karlduino/CO2monitorWifi/docs/DrillTemplate/co2_monitor_drill_template.png

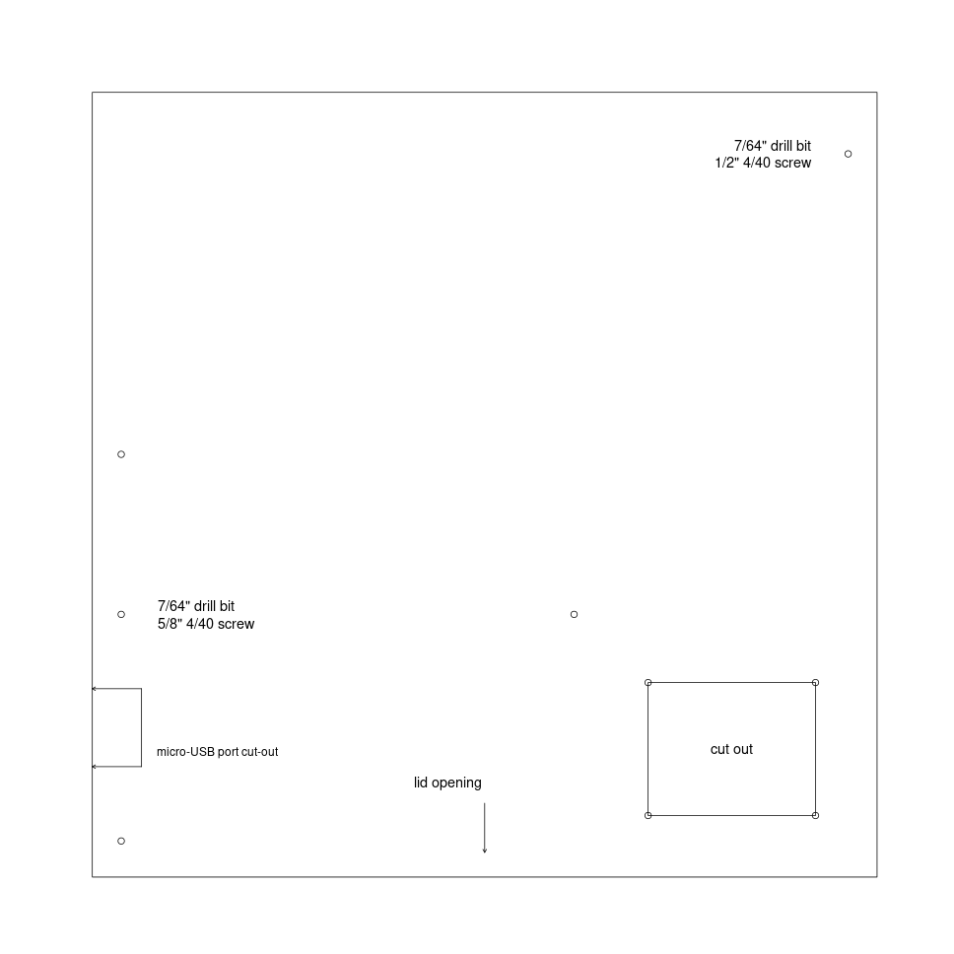
docs/DrillTemplate/co2_monitor_drill_template.png
