karlduino/CO2monitorWifi/docs/pics/01_with_template.jpg

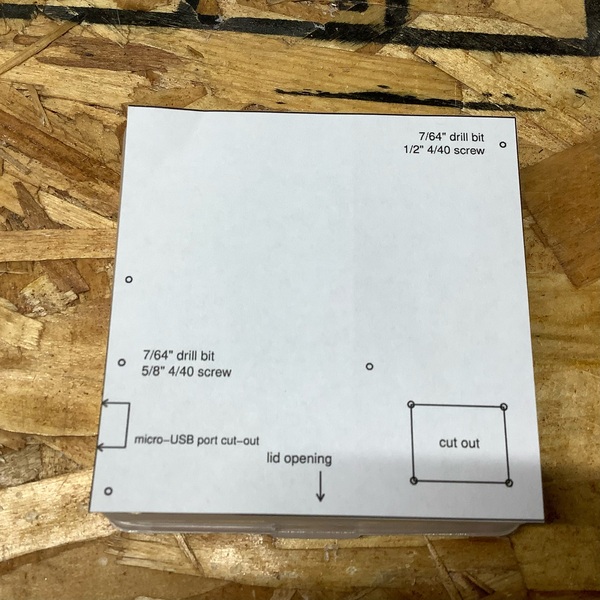
docs/pics/01_with_template.jpg
