karlduino/CO2monitorWifi/docs/pics/10_lcd_connections.jpg

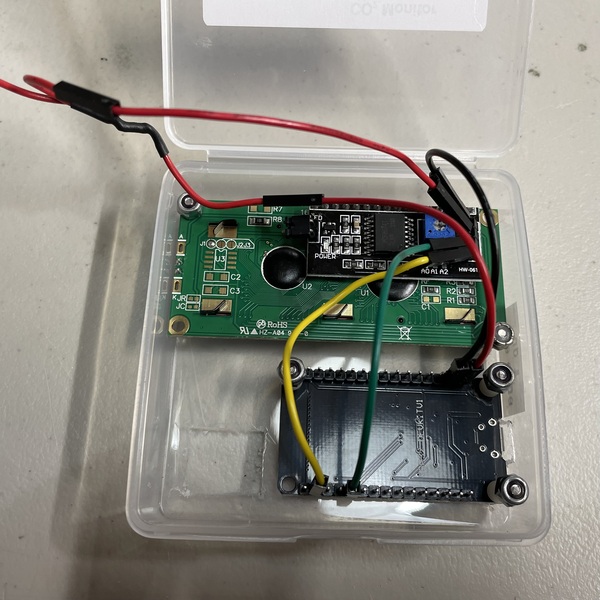
docs/pics/10_lcd_connections.jpg
