karlduino/CO2monitorWifi/docs/pics/11_all_connections.jpg

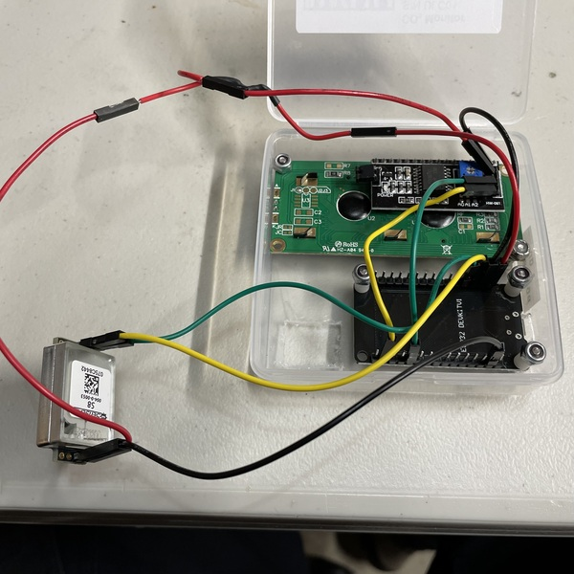
docs/pics/11_all_connections.jpg
