karlduino/CO2monitorWifi/docs/pics/esp32.jpg

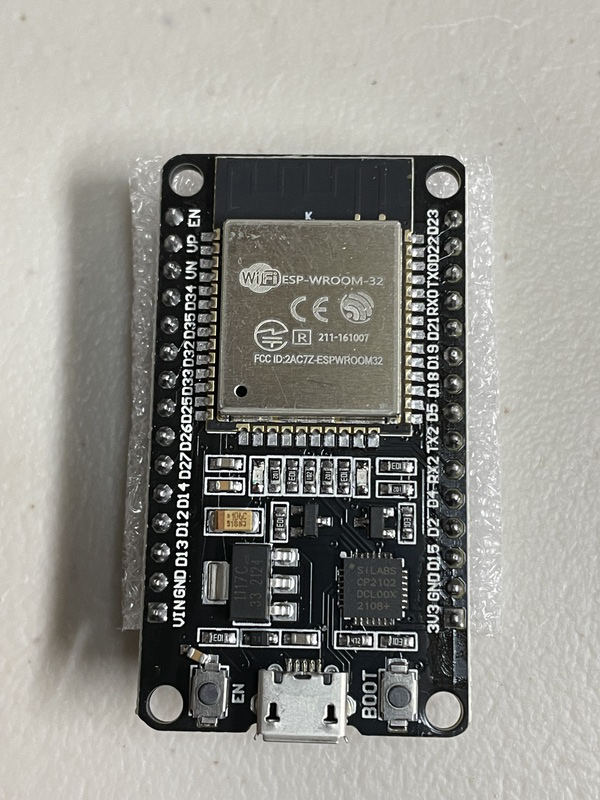
docs/pics/esp32.jpg
