karlduino/CO2monitorWifi/docs/DrillTemplate/co2_monitor_drill_template.pdf

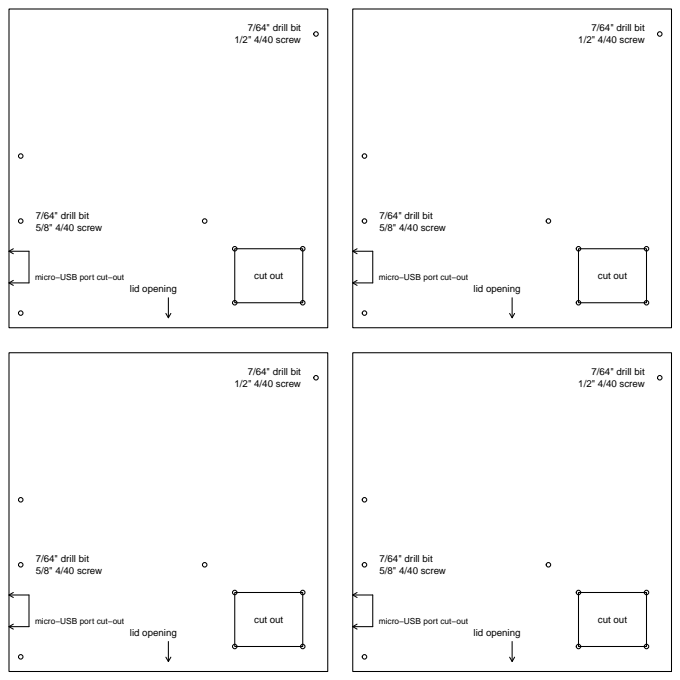
[picture p6: page 1]
7/64" drill bit 1/2" 4/40 screw; 7/64" drill bit 5/8" 4/40 screw; micro−USB port cut−out; cut out; lid opening
