karlduino/CO2monitorWifi/docs/pics/08_soldered_wire.jpg

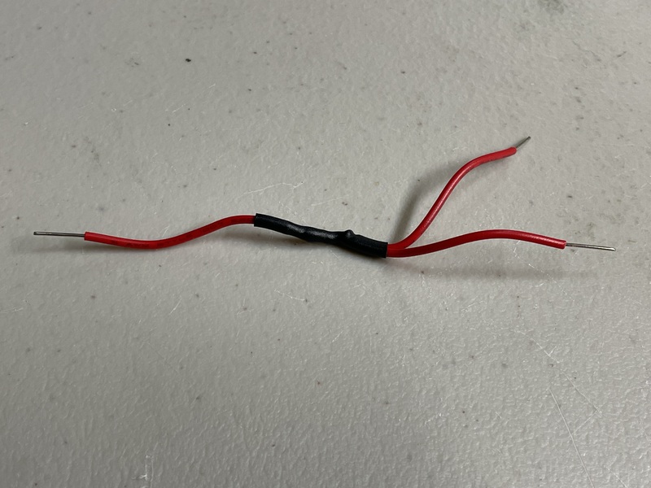
docs/pics/08_soldered_wire.jpg
