karlduino/CO2monitorWifi/docs/pics/09_components_installed.jpg

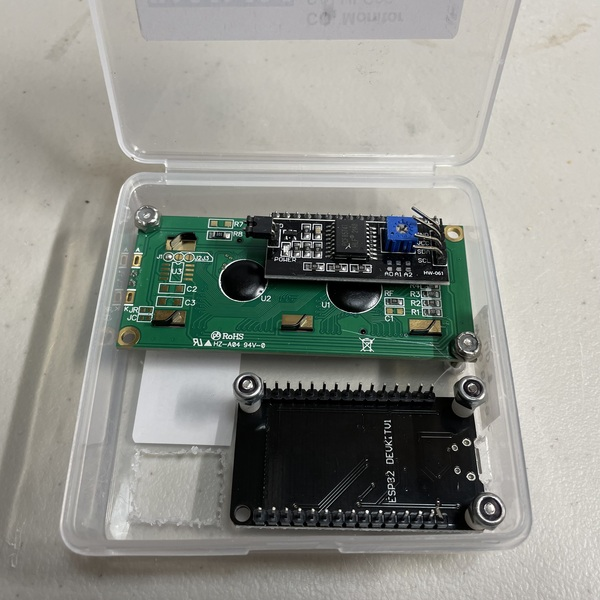
docs/pics/09_components_installed.jpg
