karlduino/CO2monitorWifi/(commit log)

2022-09-24 Add drill template; needs to be revised
2022-09-24 drill template: arduino -> esp32
    - wider and longer
    - bigger screw holes, so use 4/40 screws (5/8" long with
    1/4" plastic standoffs between the board and the nut
2022-09-24 Initial draft of assembly instructions
2022-09-24 Add some more details to the README and assembly instructions
2022-09-24 README: remove link for ESP32, which was to a rather dicey site
2022-09-25 instructions.md: Remove a couple of "TO DO" comments
2022-09-25 Replace the figure of the soldered wire
2022-09-25 README: small change in description of the ESP32 we're using
2022-09-25 Add note in README re flashing LED as indicator of wifi connection
2022-09-25 More information about the esp32 board I'm using
2022-09-25 change what board to select in Arduino IDE
2022-09-25 docs/instructions: change suggested board option
